BeckyHeath/MAARU/images/papers/maaru-paper.png

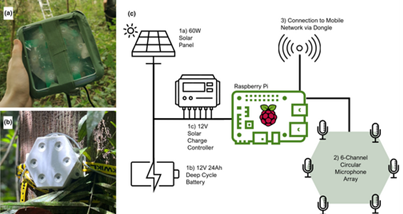
images/papers/maaru-paper.png
