BeckyHeath/MAARU/images/scc-to-step-down.jpeg

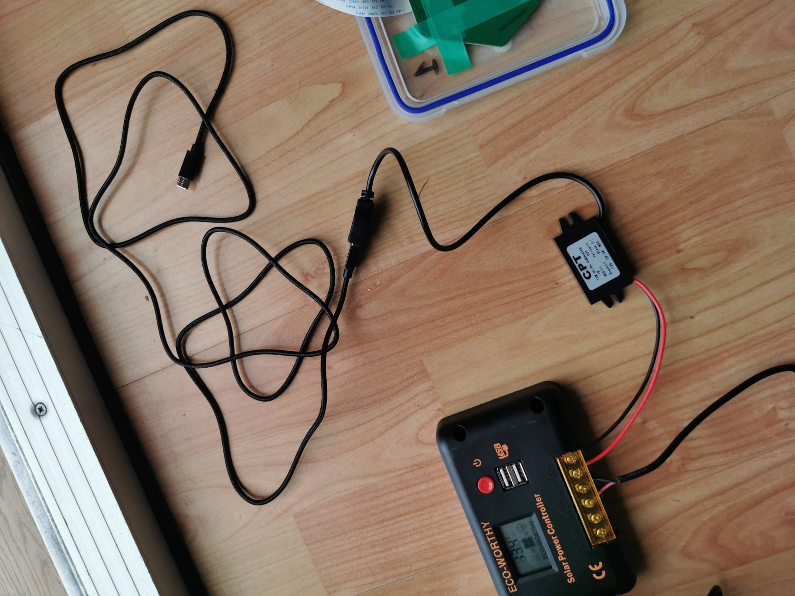
images/scc-to-step-down.jpeg
