BeckyHeath/MAARU/README.md

# MAARU Website

The codebase for the website explaining the theory and install steps for MAARU (Multichannel Acoustic Autonomous Recoring Unit)
