BeckyHeath/MAARU/images/3D-wp-shrink.png

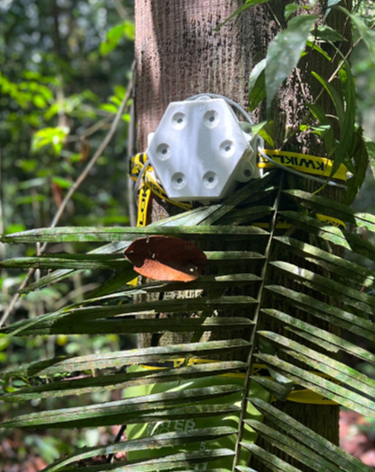
images/3D-wp-shrink.png
