BeckyHeath/MAARU/images/3Dp-wp.jpeg

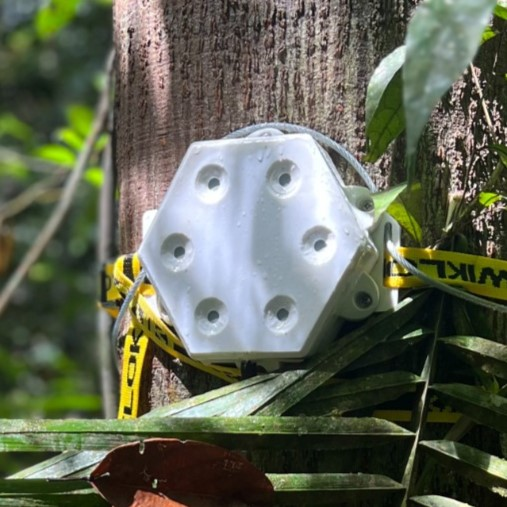
images/3Dp-wp.jpeg
