BeckyHeath/MAARU/images/all-connected.jpeg

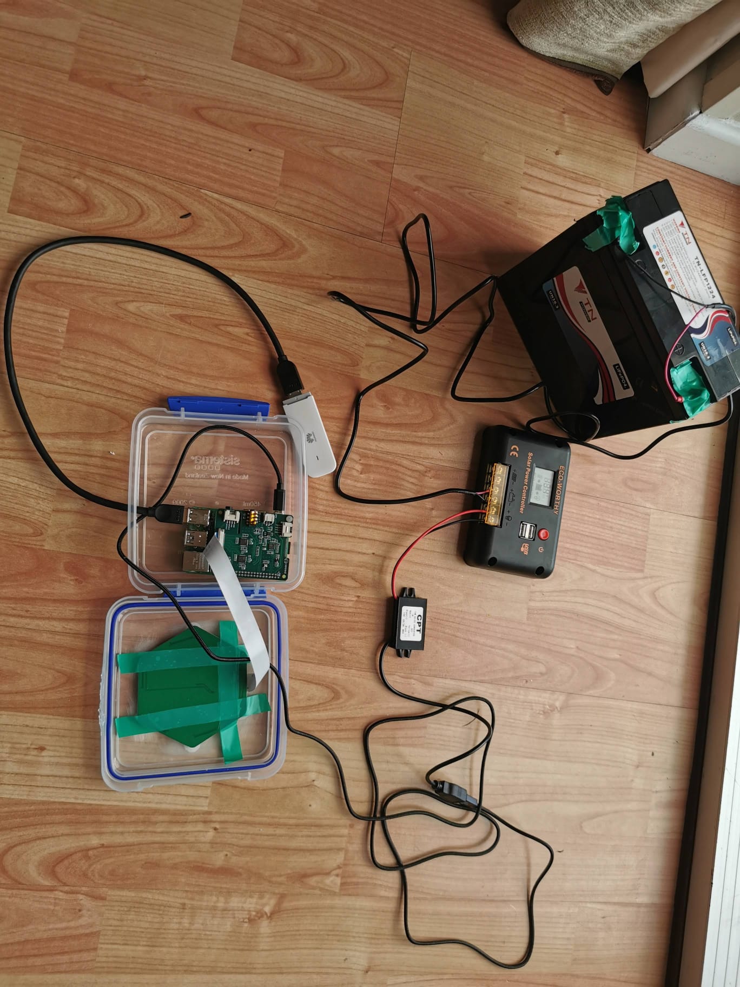
images/all-connected.jpeg
