BeckyHeath/MAARU/images/attach-dongle.jpeg

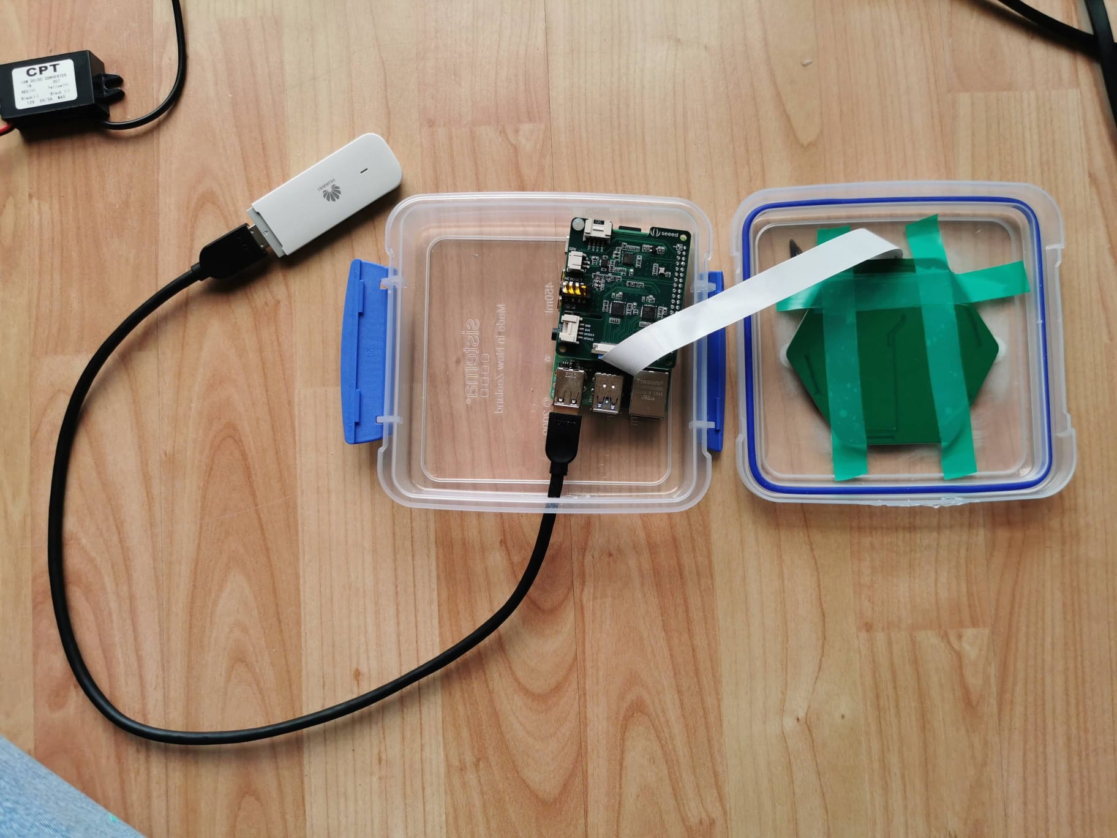
images/attach-dongle.jpeg
