BeckyHeath/MAARU/images/battery-scc.png

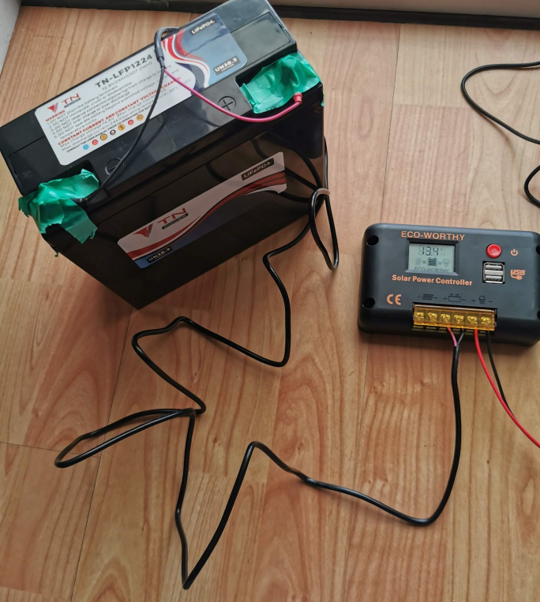
images/battery-scc.png
