BeckyHeath/MAARU/images/battery-to-scc.jpeg

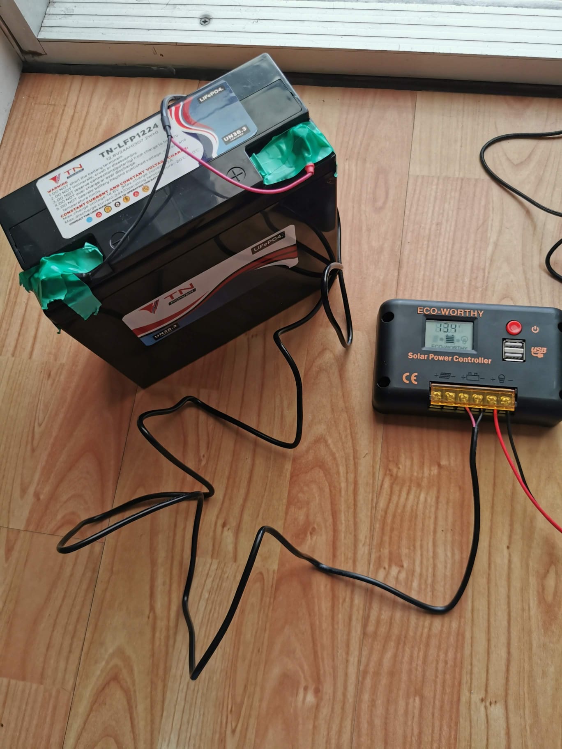
images/battery-to-scc.jpeg
