BeckyHeath/MAARU/images/bird.png

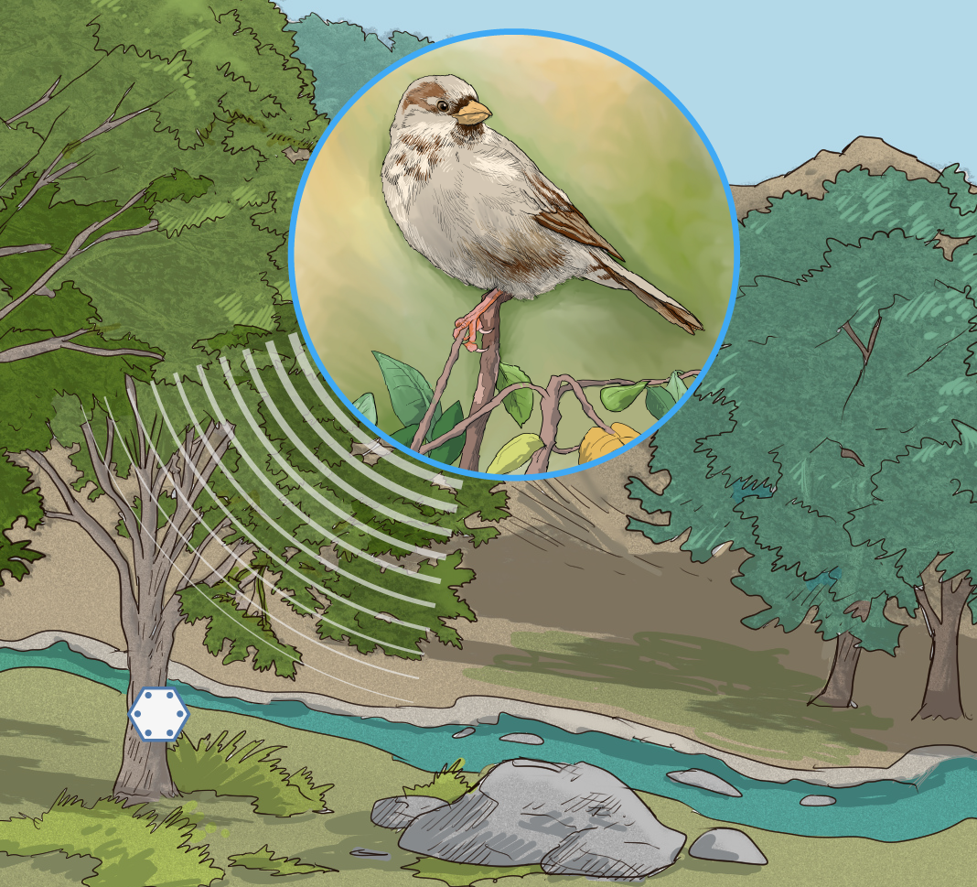
images/bird.png
