BeckyHeath/MAARU/images/diy-wp-square.png

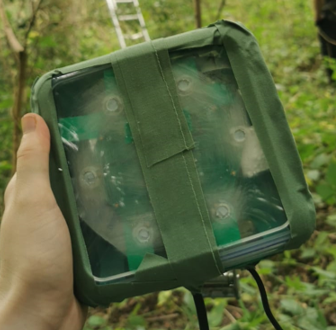
images/diy-wp-square.png
