BeckyHeath/MAARU/images/DIY-wp.jpg

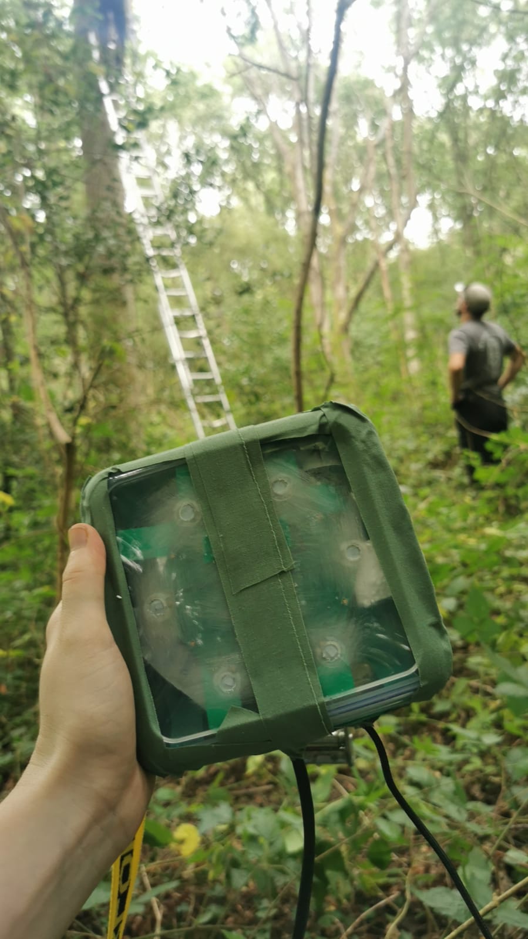
images/DIY-wp.jpg
