BeckyHeath/MAARU/images/GraphicalAbstract-Blurred.jpg

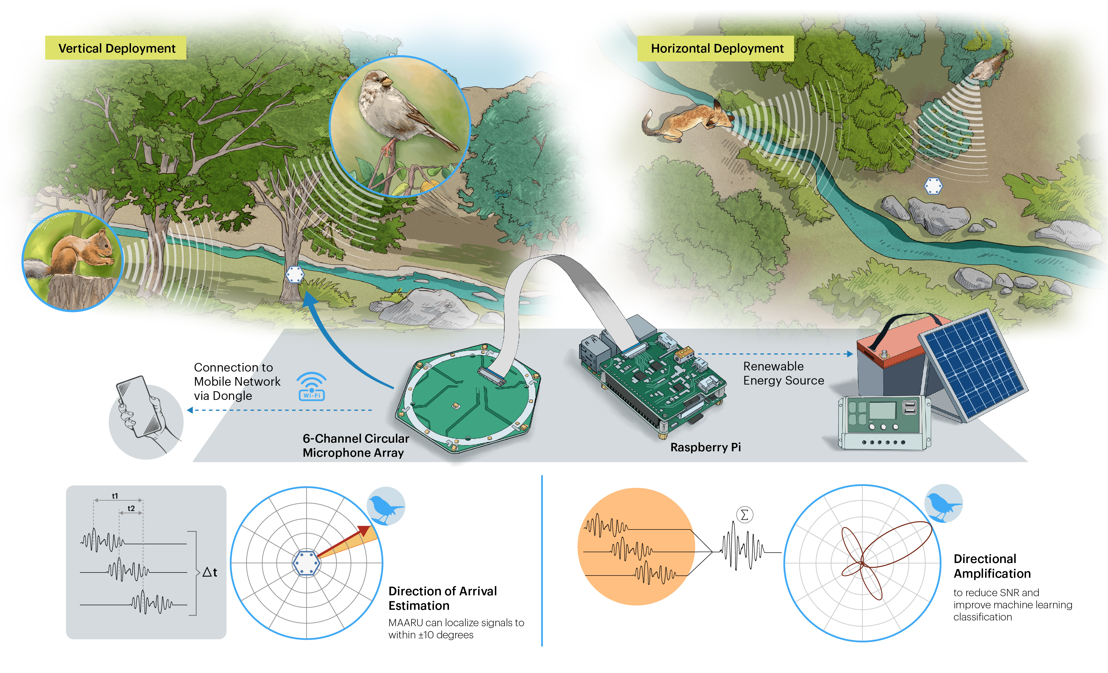
images/GraphicalAbstract-Blurred.jpg
