BeckyHeath/MAARU/images/horizontal-borderless.png

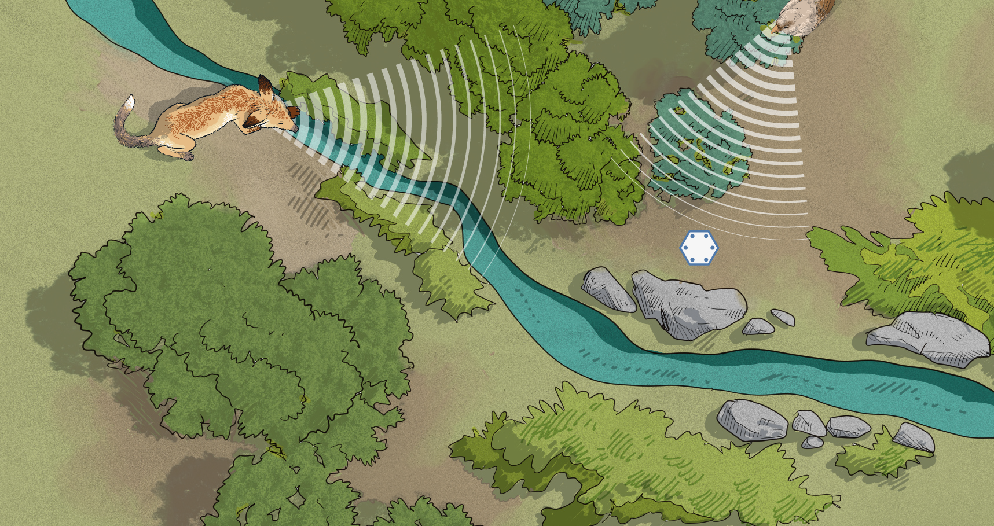
images/horizontal-borderless.png
