BeckyHeath/MAARU/images/horizontal.png

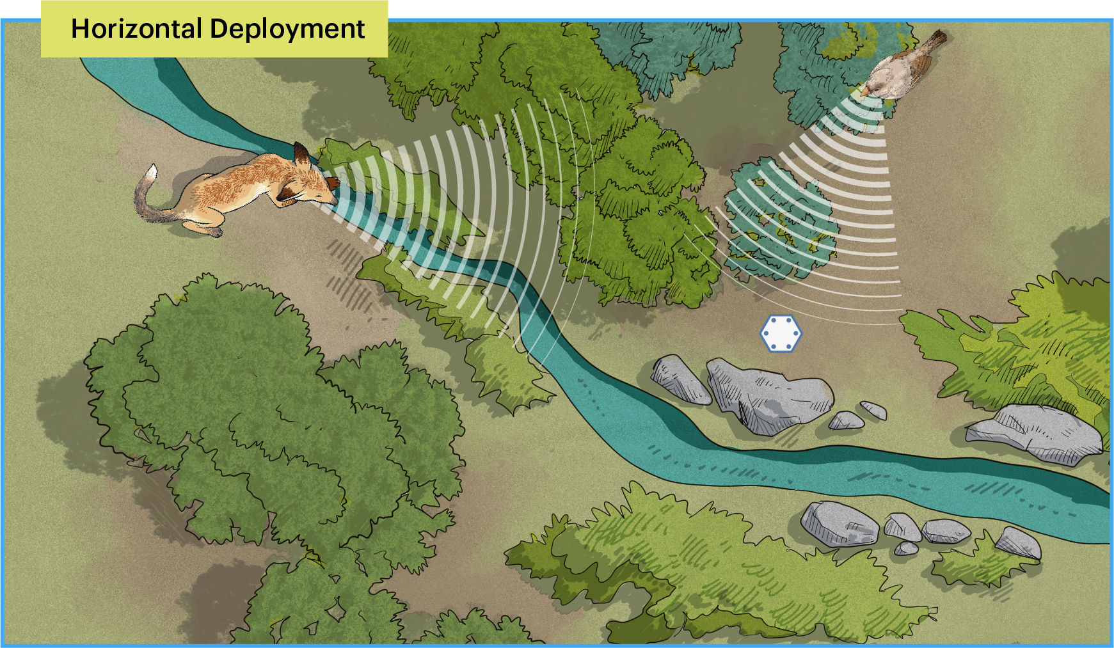
images/horizontal.png
