BeckyHeath/MAARU/images/KCC.png

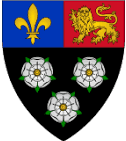
images/KCC.png
