BeckyHeath/MAARU/images/MAARU_Schematic.png

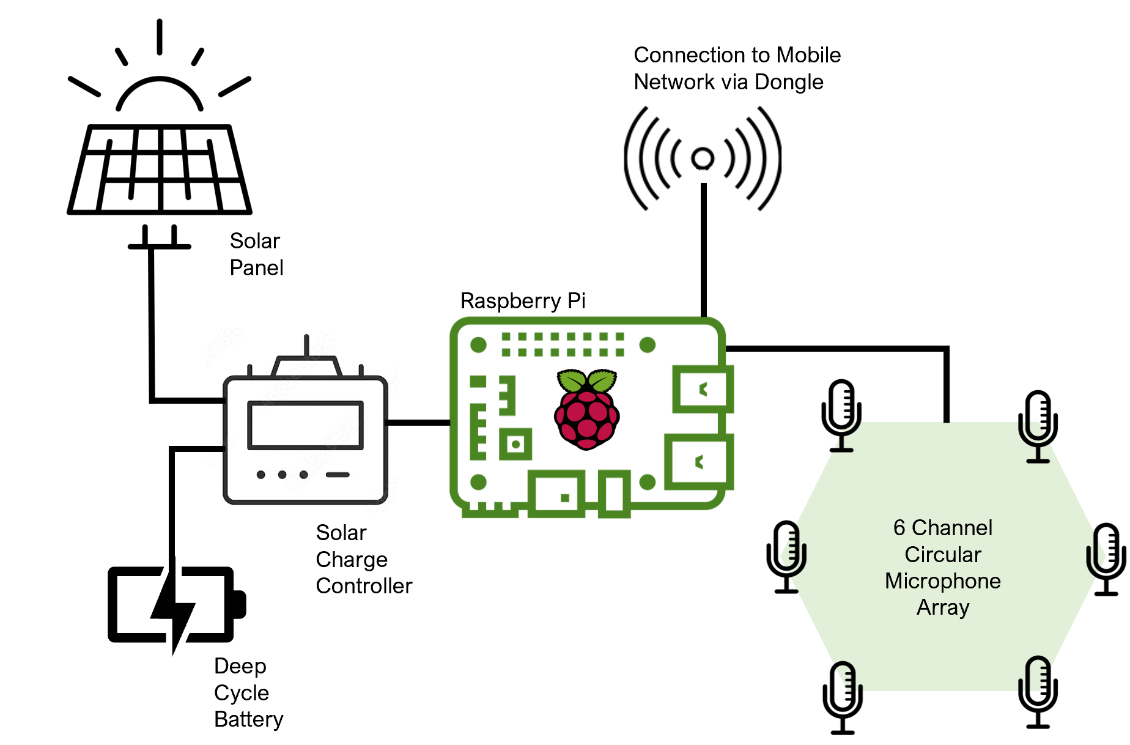
images/MAARU_Schematic.png
