BeckyHeath/MAARU/images/papers/recording-nature.png

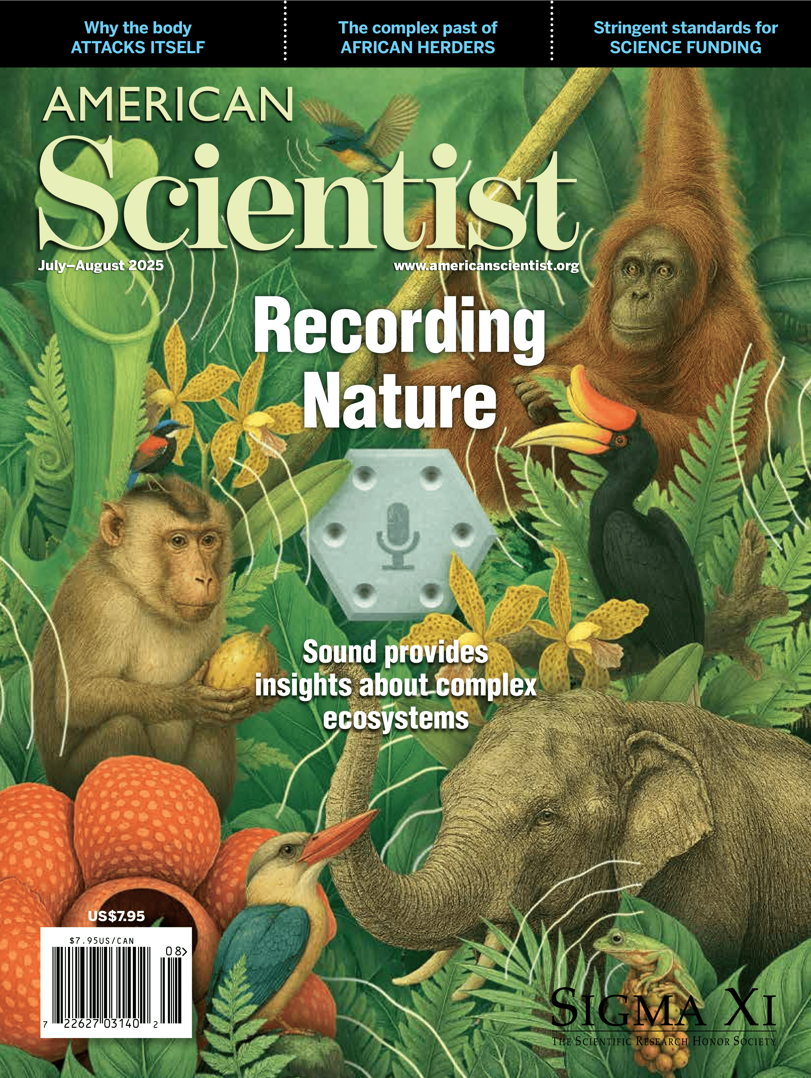
images/papers/recording-nature.png
