BeckyHeath/MAARU/images/papers/vse-paper.jpg

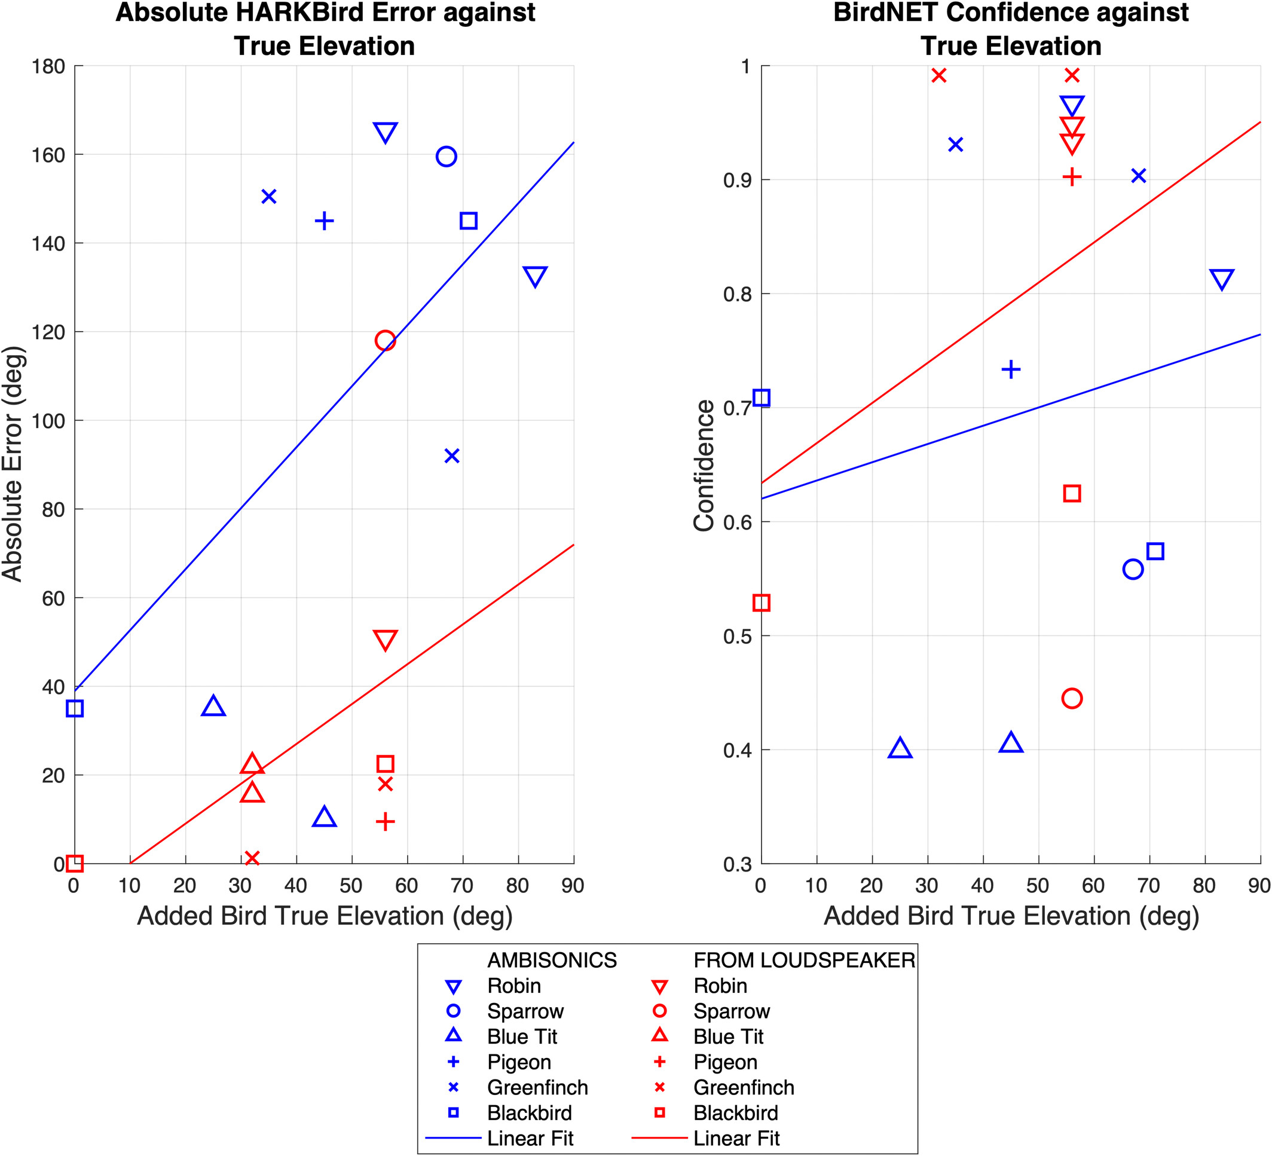
images/papers/vse-paper.jpg
