BeckyHeath/MAARU/images/people/BH.jpg

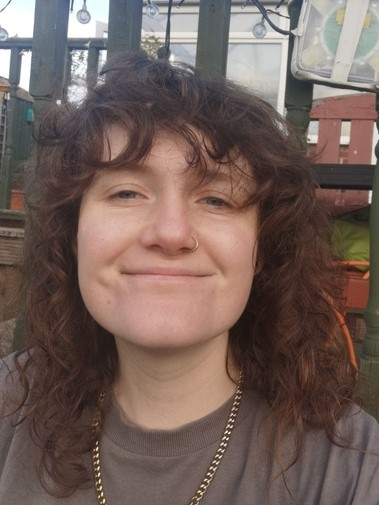
images/people/BH.jpg
