BeckyHeath/MAARU/images/people/JS.jpg

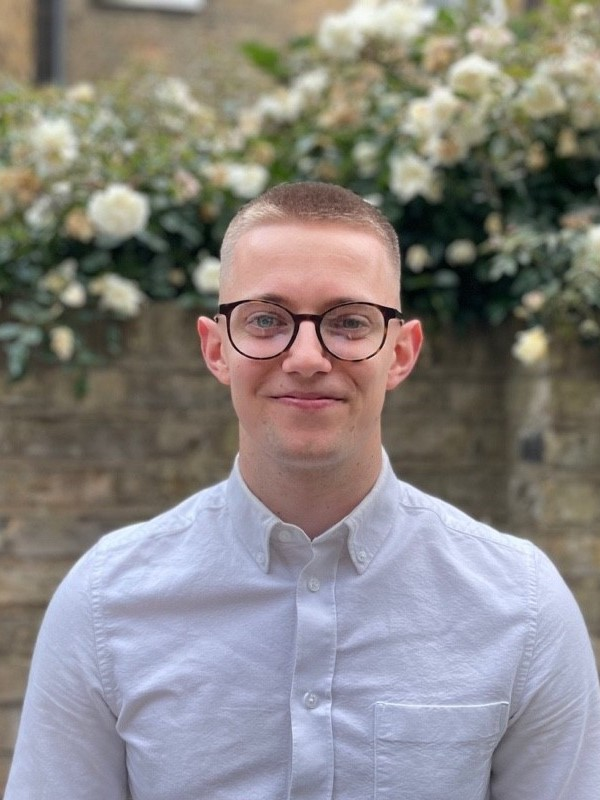
images/people/JS.jpg
