BeckyHeath/MAARU/images/people/LP.jpg

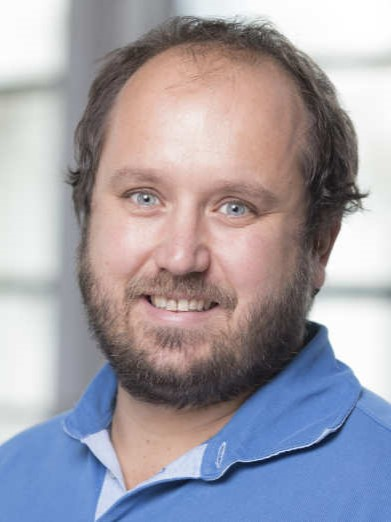
images/people/LP.jpg
