BeckyHeath/MAARU/images/people/NLP.jpg

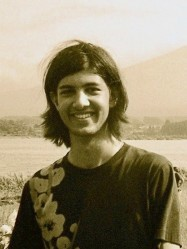
images/people/NLP.jpg
