BeckyHeath/MAARU/images/people/RE.jpg

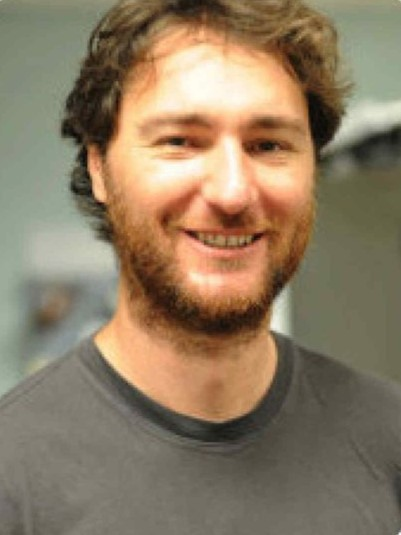
images/people/RE.jpg
