BeckyHeath/MAARU/images/people/RM.png

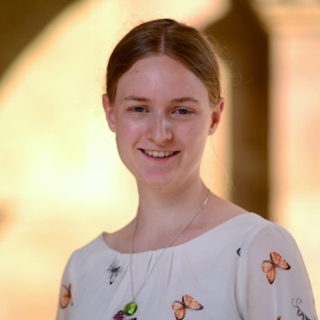
images/people/RM.png
