BeckyHeath/MAARU/images/people/RS.png

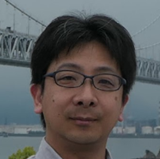
images/people/RS.png
