BeckyHeath/MAARU/images/people/SS.jpg

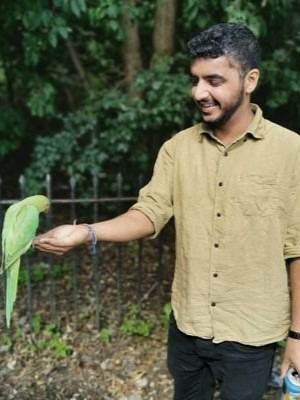
images/people/SS.jpg
