BeckyHeath/MAARU/images/phone.png

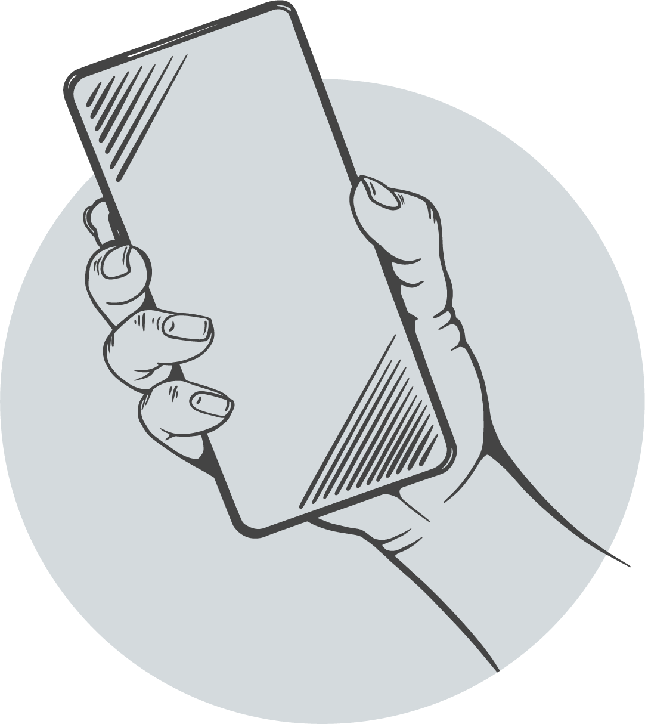
images/phone.png
