BeckyHeath/MAARU/images/powering.png

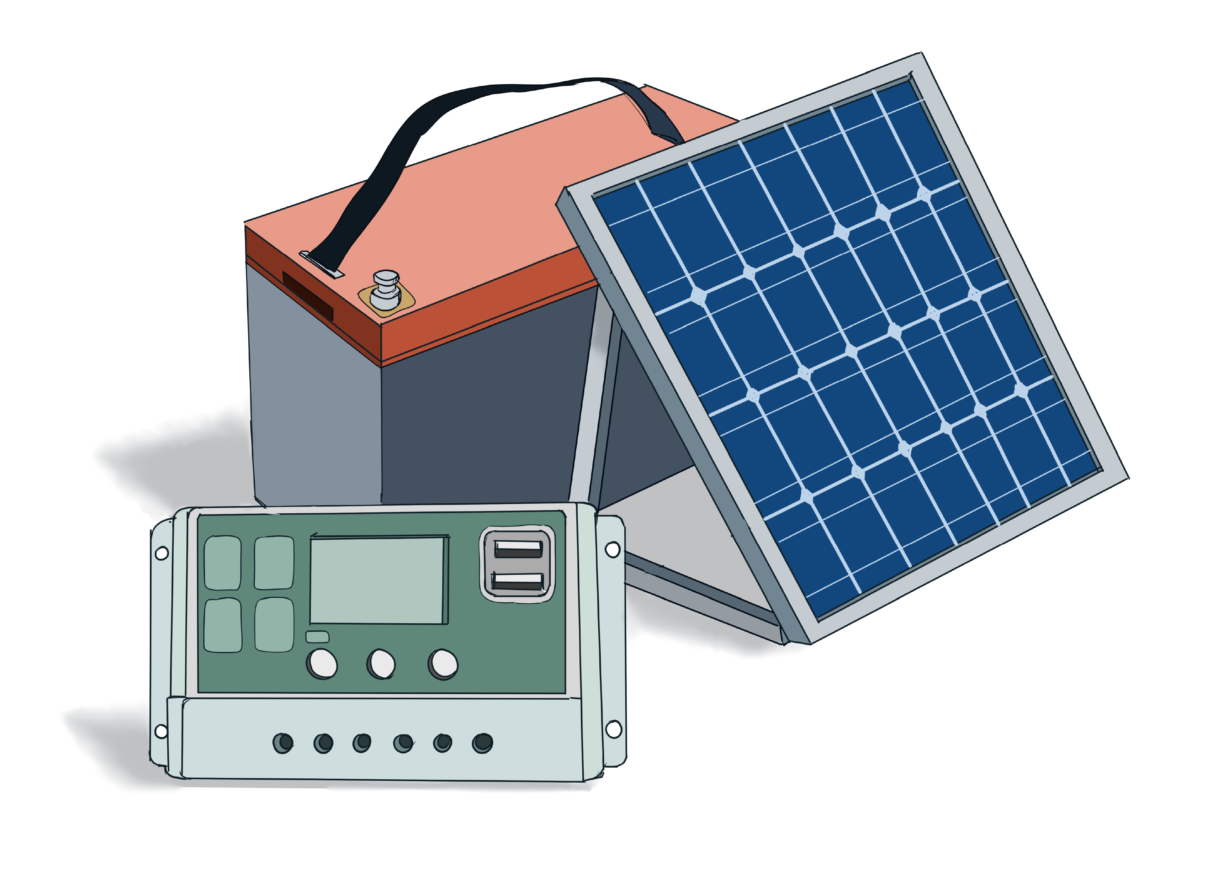
images/powering.png
