BeckyHeath/MAARU/images/Rpi-Array.png

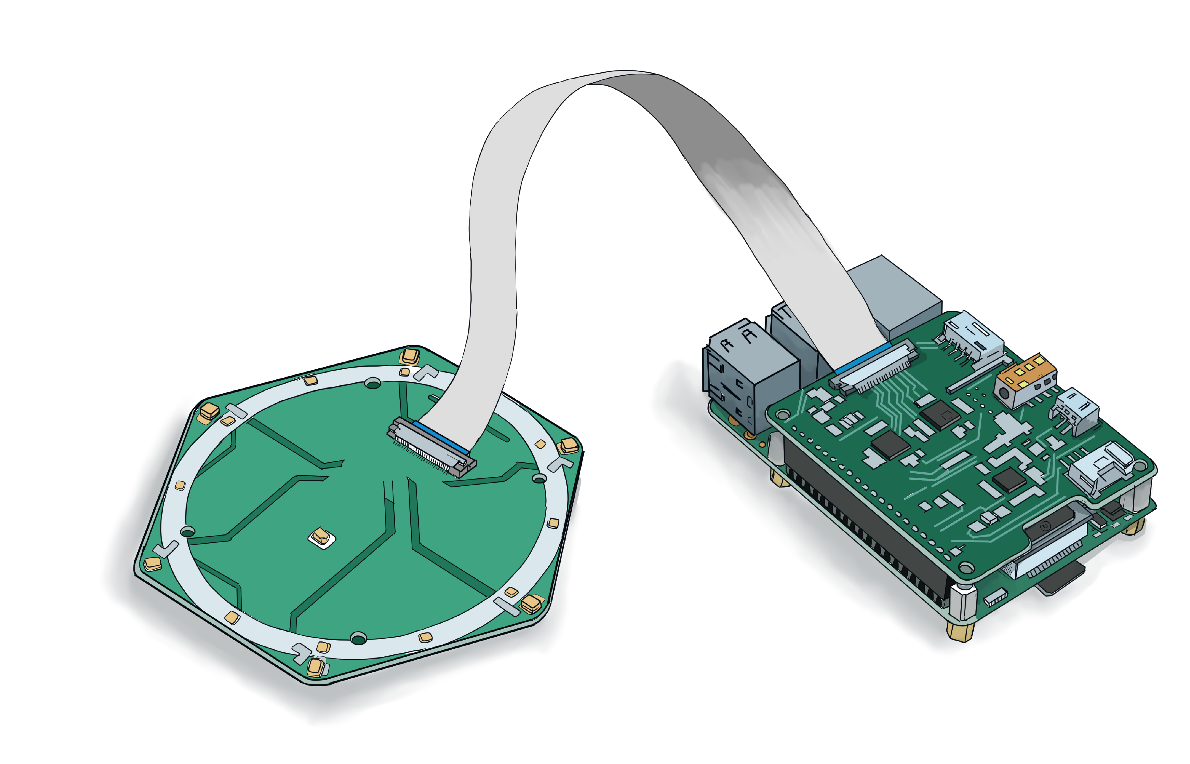
images/Rpi-Array.png
