BeckyHeath/MAARU/images/scc-stepdown.png

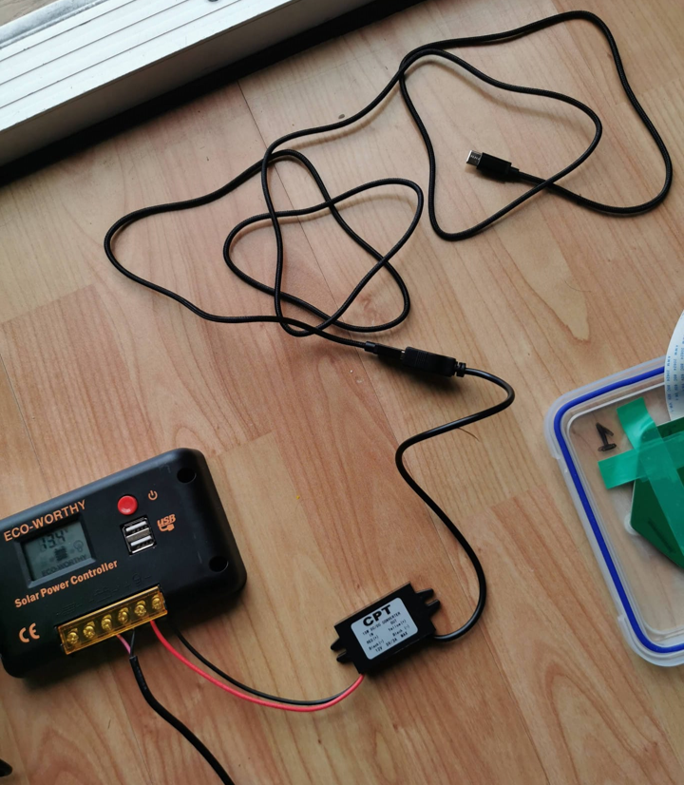
images/scc-stepdown.png
