BeckyHeath/MAARU/images/sealedTuppholes.png

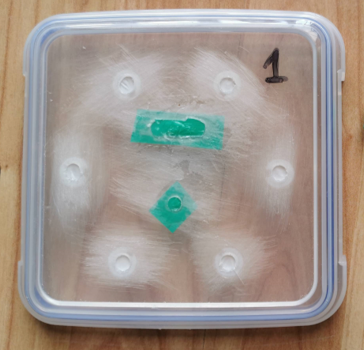
images/sealedTuppholes.png
