BeckyHeath/MAARU/images/solar-charge-controller.jpeg

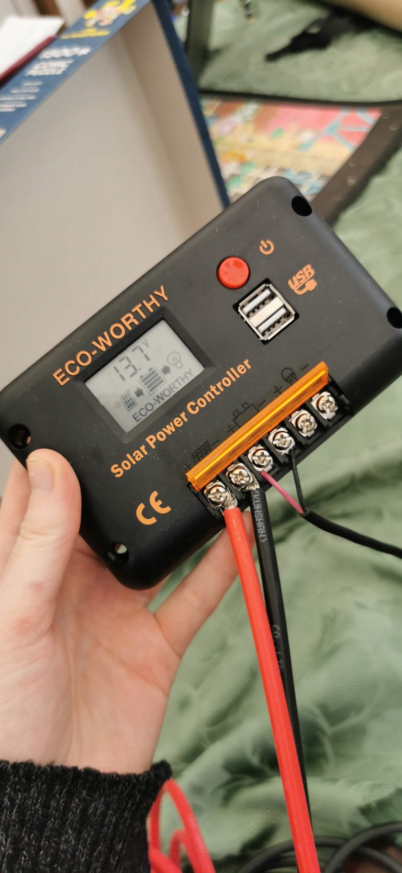
images/solar-charge-controller.jpeg
