BeckyHeath/MAARU/images/solar-panel.jpeg

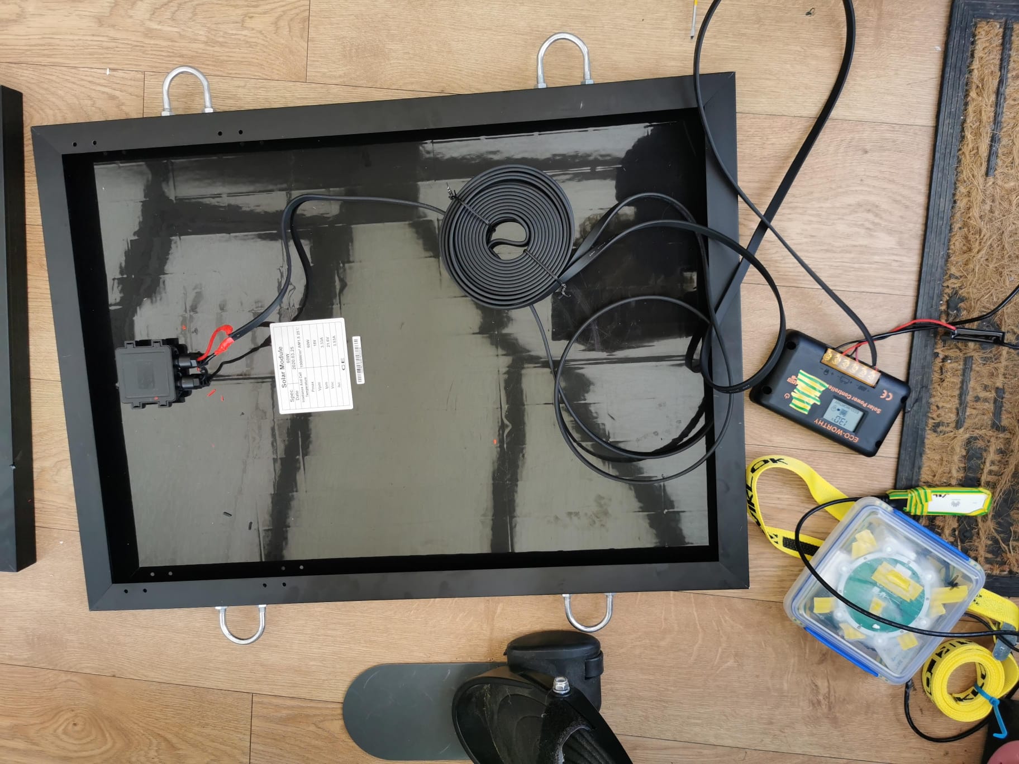
images/solar-panel.jpeg
