BeckyHeath/MAARU/images/solar-scc.png

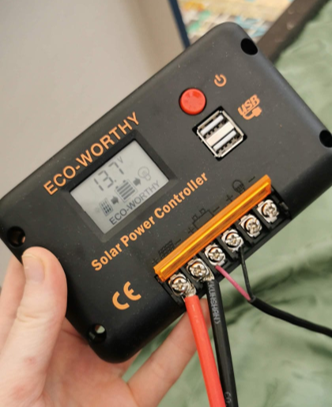
images/solar-scc.png
