BeckyHeath/MAARU/images/Spatial-Acoustics-Diagrams.png

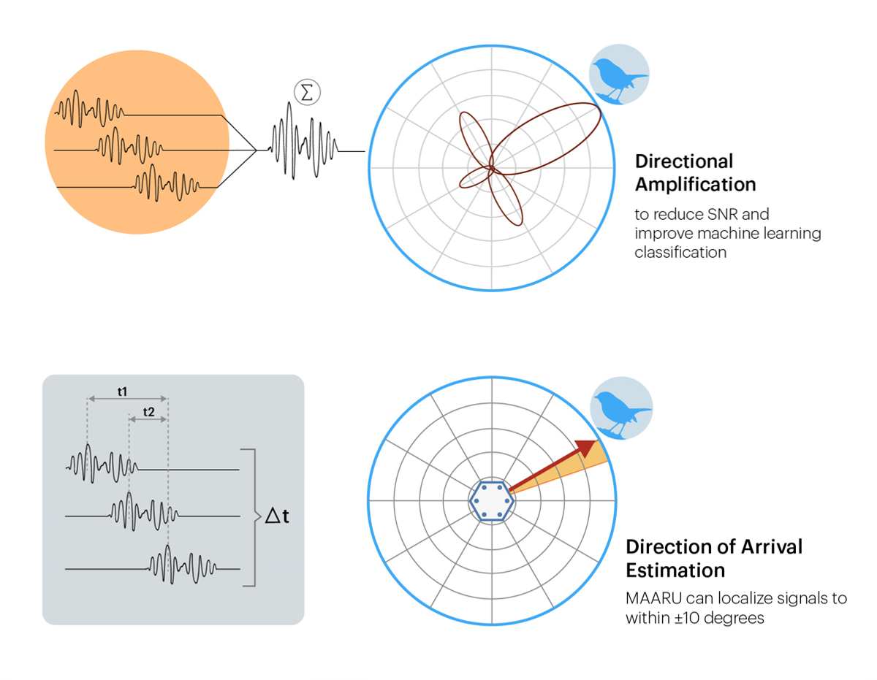
images/Spatial-Acoustics-Diagrams.png
