BeckyHeath/MAARU/images/tuppaware-holes.jpeg

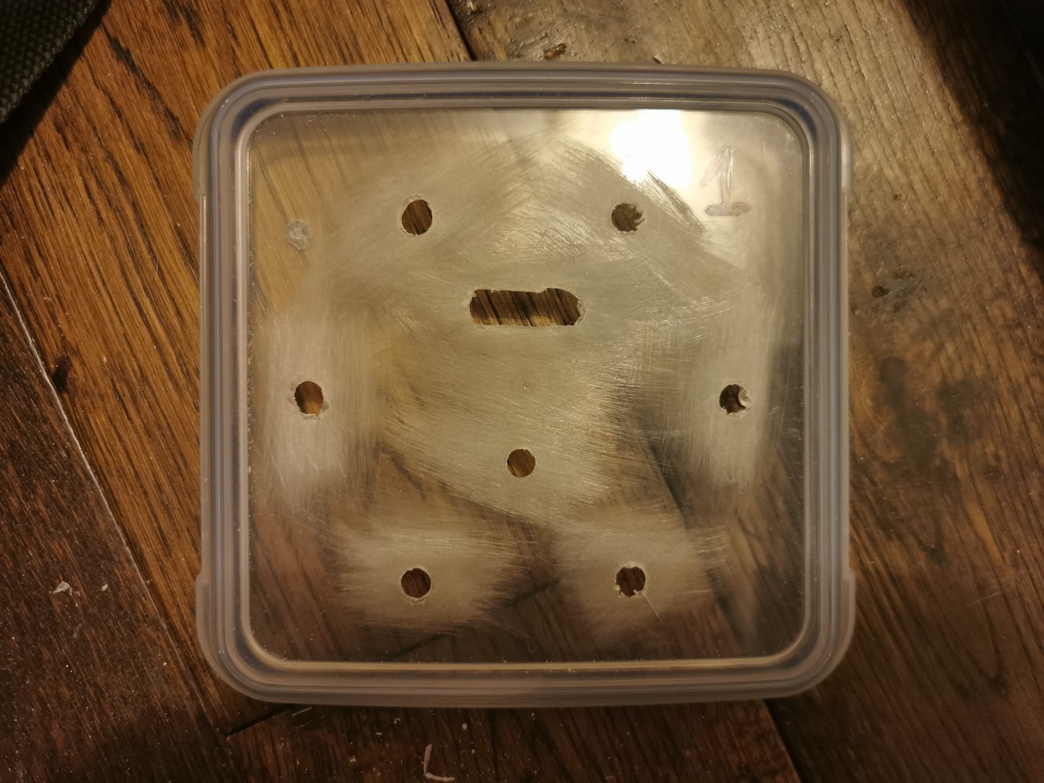
images/tuppaware-holes.jpeg
