BeckyHeath/MAARU/images/tupperware-holes.jpg

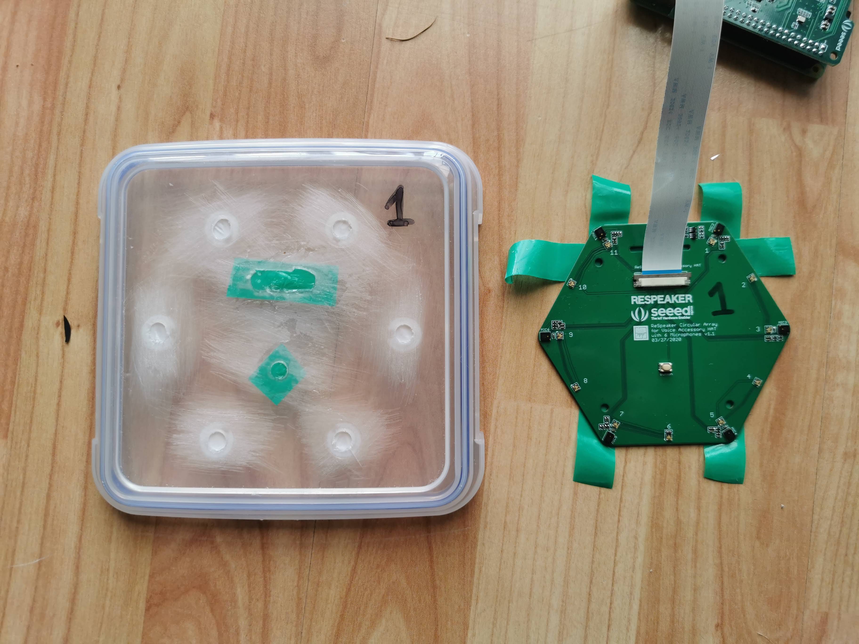
images/tupperware-holes.jpg
