BeckyHeath/MAARU/images/tuppholes.png

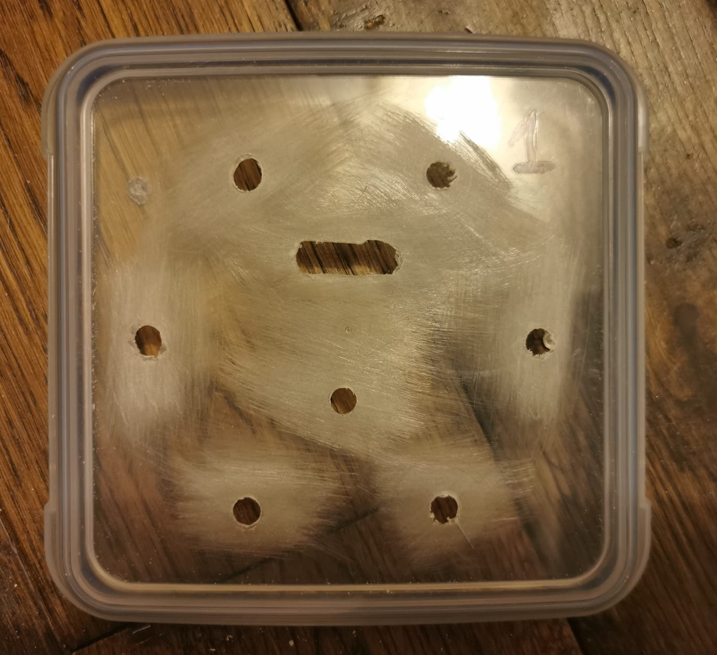
images/tuppholes.png
