BeckyHeath/MAARU/images/vertical.png

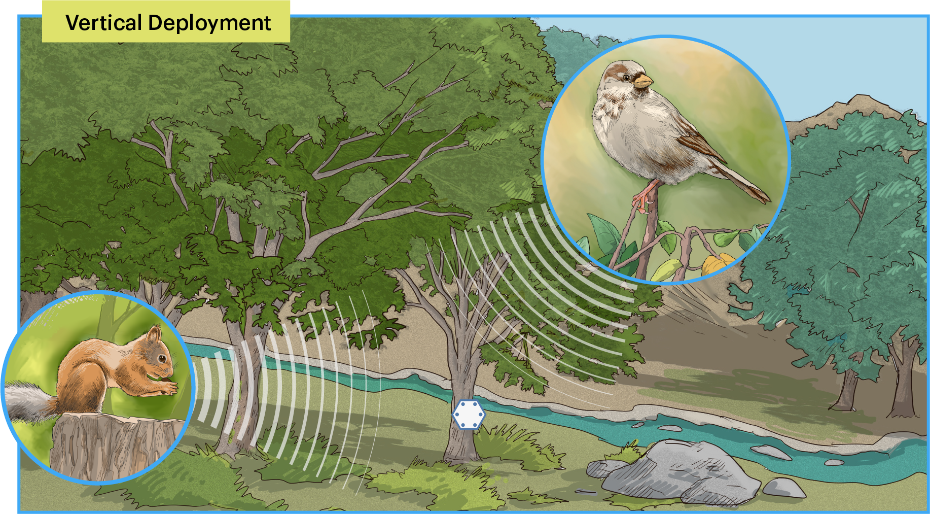
images/vertical.png
