BeckyHeath/MAARU/images/WhatsApp Image 2023-10-13 at 04.29.46.jpeg

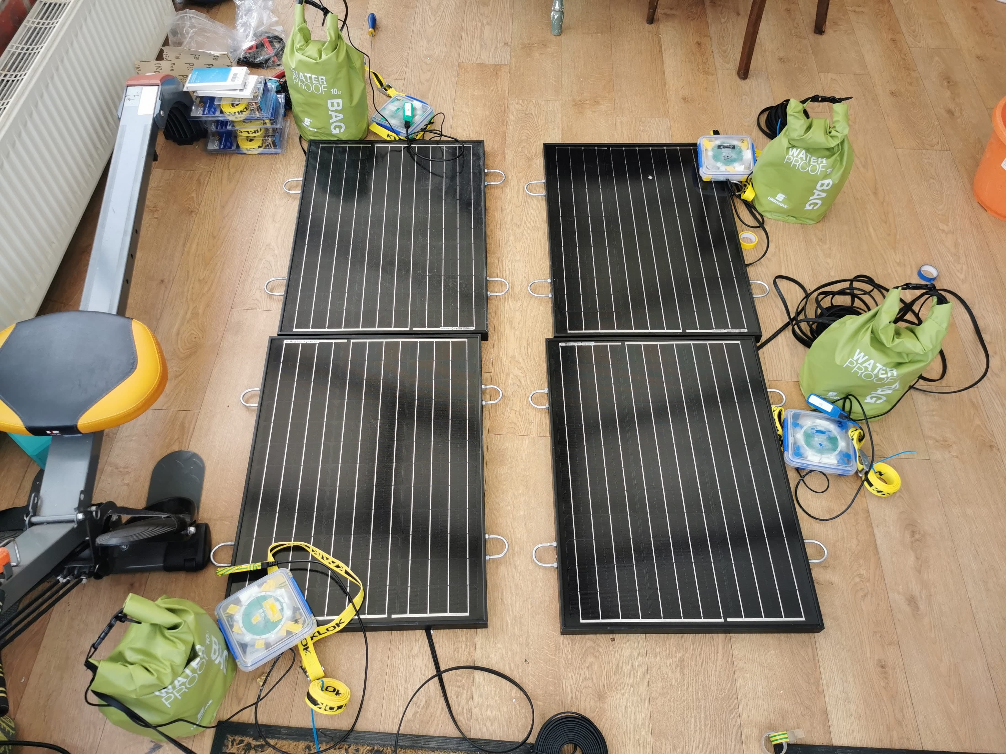
images/WhatsApp Image 2023-10-13 at 04.29.46.jpeg
