BeckyHeath/MAARU/images/whole-device.png

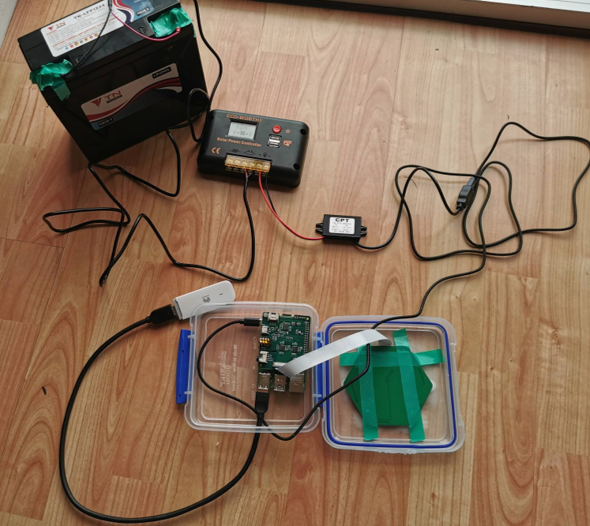
images/whole-device.png
