BeckyHeath/MAARU/images/zoom.jpg

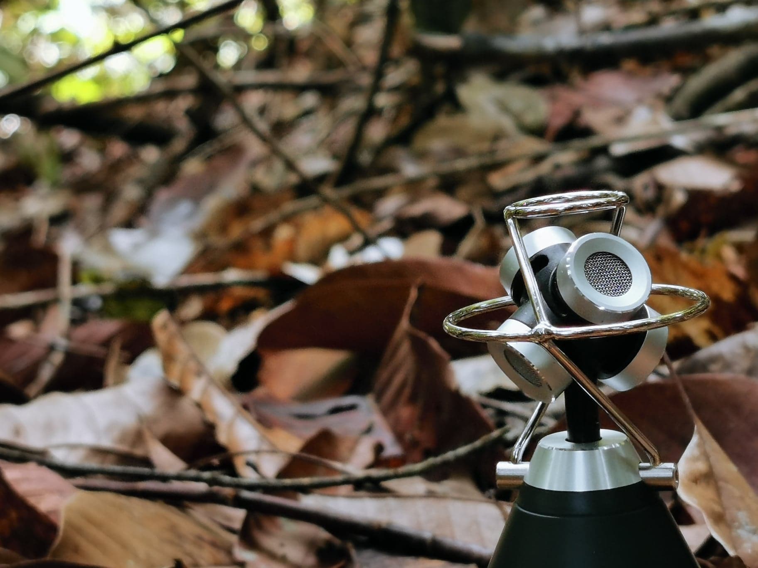
images/zoom.jpg
