BeckyHeath/MAARU/documents/3D-case/CAD Files/AMARU_TopCase.STL

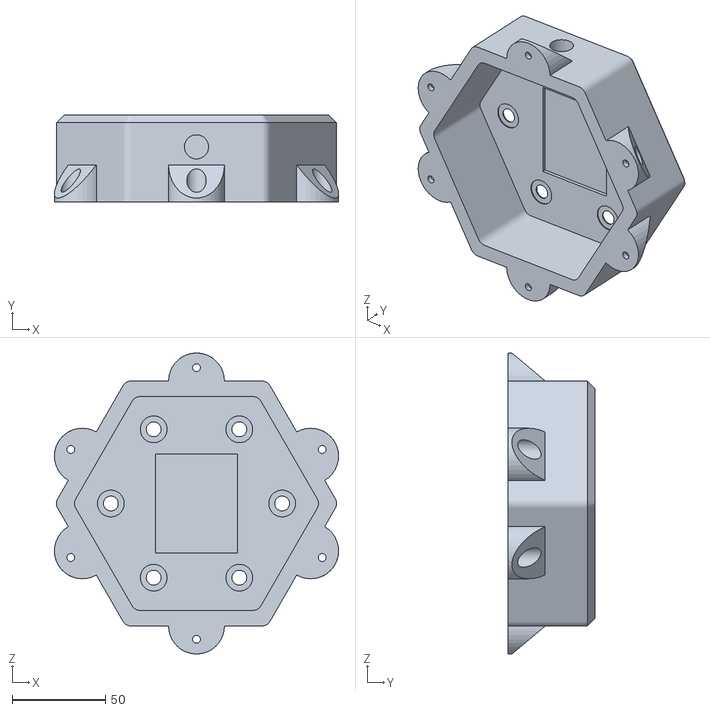
[picture p58: CAD file, 2023-10-15]
documents/3D-case/CAD Files/AMARU_TopCase.STL
152.6 x 46.5 x 161.6
