BeckyHeath/MAARU/documents/3D-case/CAD Files/AMARU_BasePlate.STL

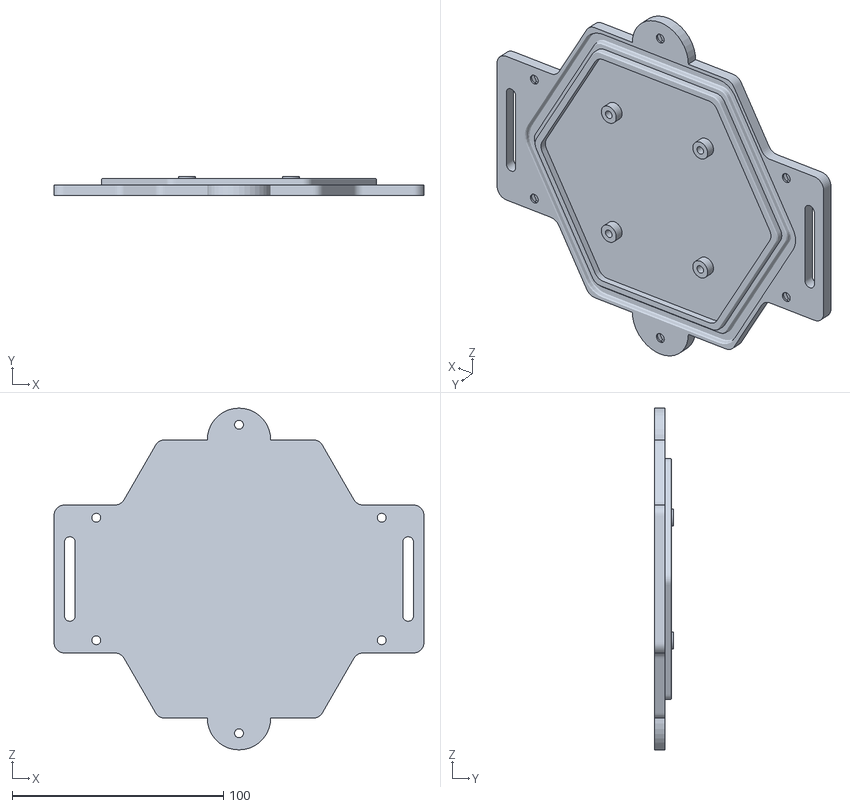
[picture p59: CAD file, 2023-10-15]
documents/3D-case/CAD Files/AMARU_BasePlate.STL
175.0 x 9.00 x 161.6
