BeckyHeath/MAARU/documents/3D-case/Assembly_Instructions.pdf

James Skinner, June 2023
AMARU - Step-by-step Assembly Instructions

Overview

This documentation refers to assembly of the Amazon Multichannel Autonomous Recording Unit (AMARU): developed for James Skinner’s master’s project.

For a list of required components and links to purchase them, refer to this spreadsheet. (https://docs.google.com/spreadsheets/d/1wotfAZApMUj4tcFPdh2UBsMQqyj9QS6KycnfAqtqY8s/edit?usp=sharing)

Tools required to perform this assembly:

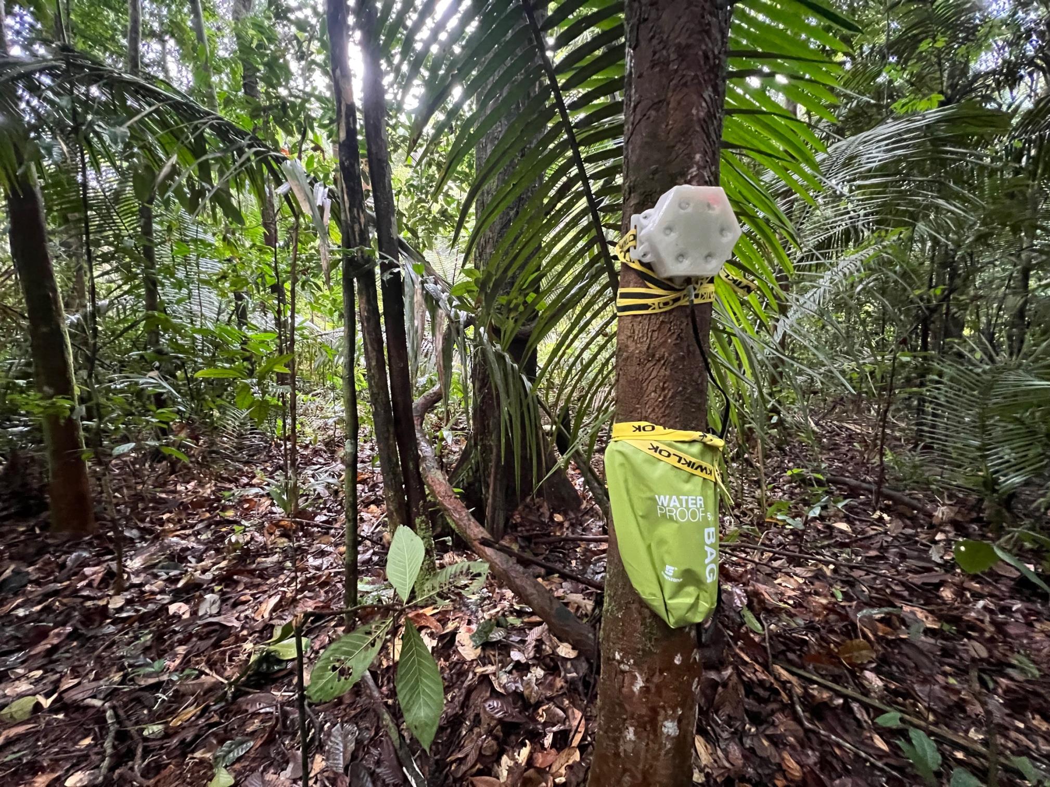
[picture p63: figure]

- 3D Printer (I used a Prusa MK3S)
- Pliers
- Deburring Tool
- Paintbrush
- Gloves
- Plastic Cups
- Mixing Sticks
- Cutting Mat
- Stanley Knife
- Soldering Iron
- Small Screwdriver
- Tweezers
- Duct Tape

Assembly

1 | 2 | 3 | 4

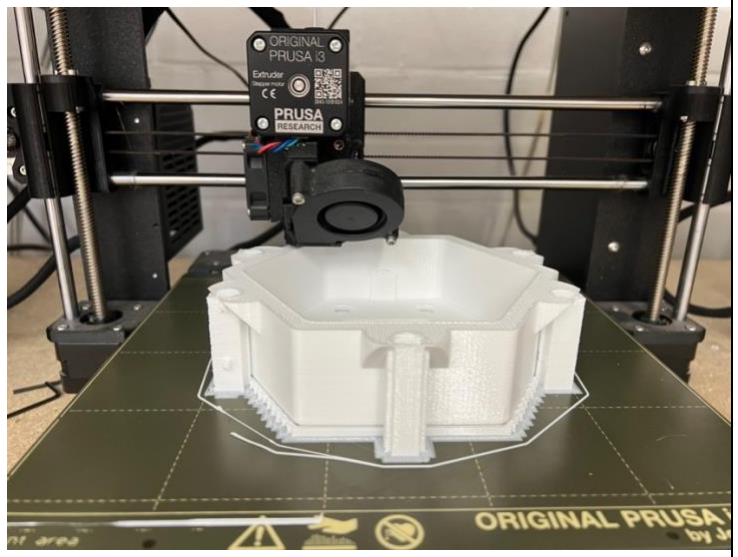
[picture p64: figure]
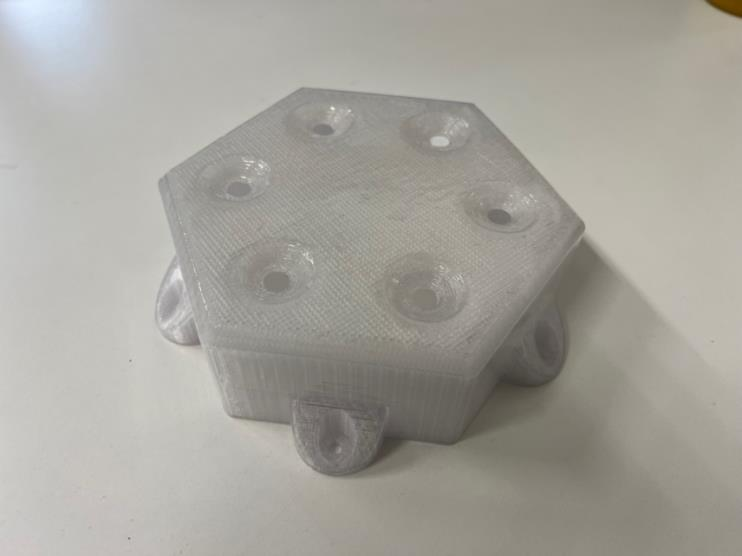
[picture p65: figure]
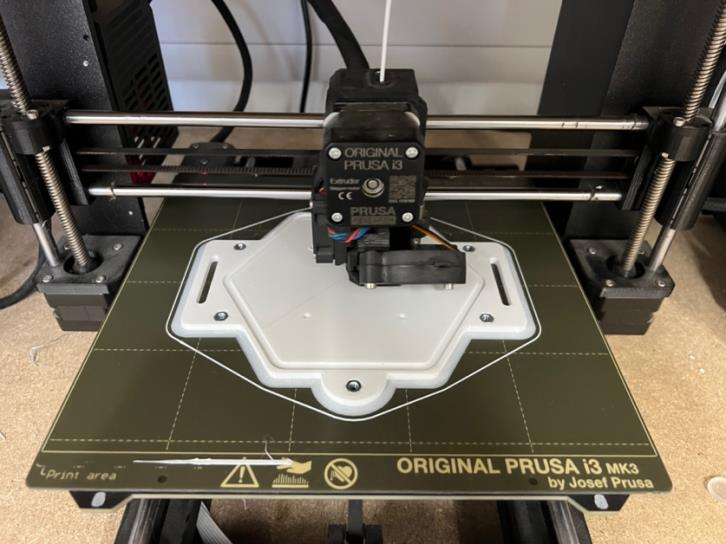
[picture p66: figure]
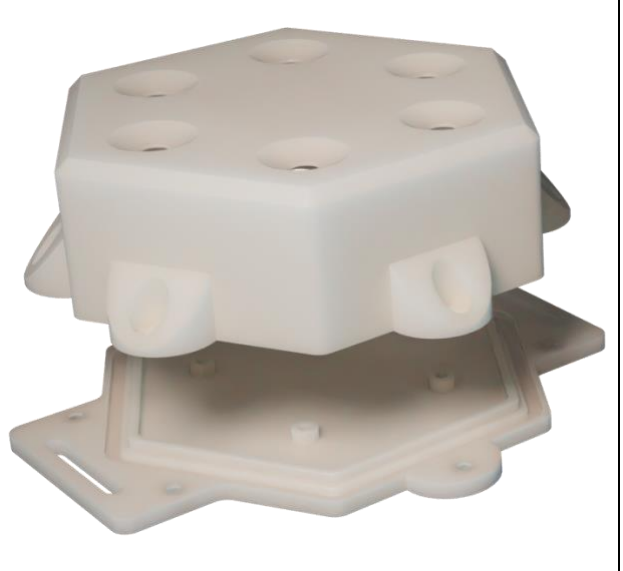
[picture p67: figure]

Download the AMARU casing STL files from the following link: STL Files (https://drive.google.com/drive/folders/1b9wD-DWbqm3pzwqg_jkfNGsdnzan1Paq?usp=share_link) | Use a 3D printer to print the casing, using PETG. The following settings should be used: 3-layer wall thickness, 0.2 mm layer height, 40% infill density. | Add a print pause before printing the base plate, at the layer before hex-nut holes are covered. Once paused, insert the 6 hexnuts into their respective positions. | Once the parts are printed, remove any support material. A small pair of pliers and a deburring tool are useful, here.
5 | 6 | 7 | 8

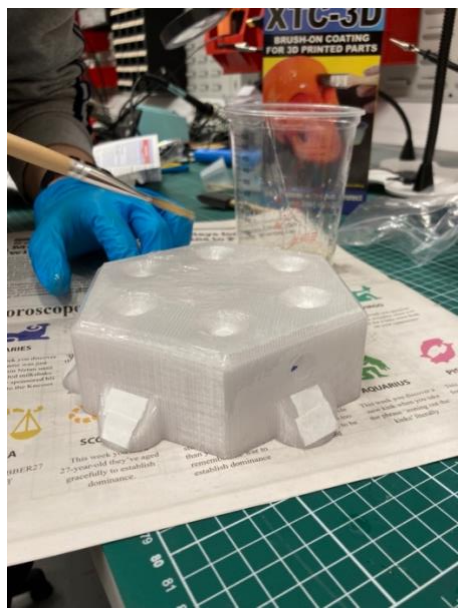
[picture p68: figure]

Apply two coats of XTC-3D epoxy resin to both parts of the casing. Make sure to wear gloves and a ventilation mask. Allow to dry between coats for at least 24 hours.

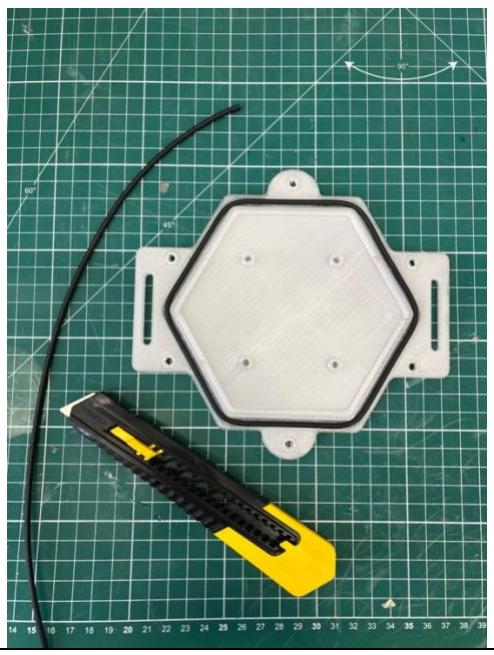
[picture p69: figure]

Measure out an appropriate length of O-ring tubing. This should fit within the gland: slightly loose. Cut to the correct length. Then, use a small amount of super glue to attach the ends together. Place the O-ring within the gland.

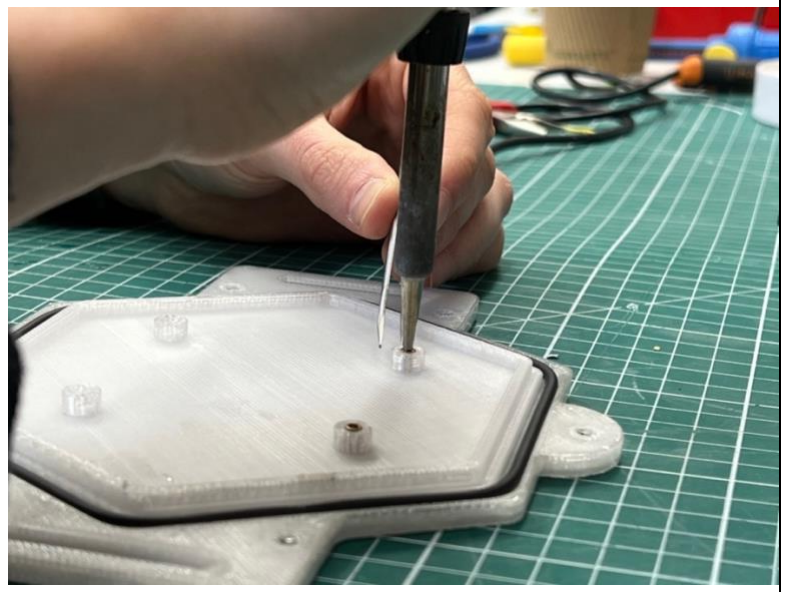
[picture p70: figure]

Use tweezers and a soldering iron to carefully melt the threaded inserts into place. The inserts heat up very quickly, so ensure they are properly aligned with the holes before applying the soldering iron.

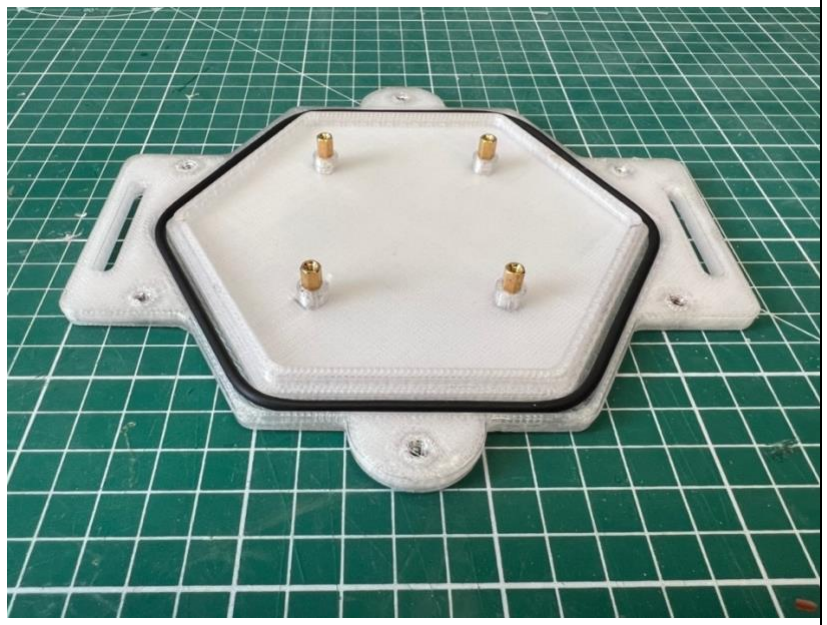
[picture p71: figure]

Screw the 4 M2.5*6+6 metal standoff screws into the threaded inserts.

9 | 10 | 11 | 12

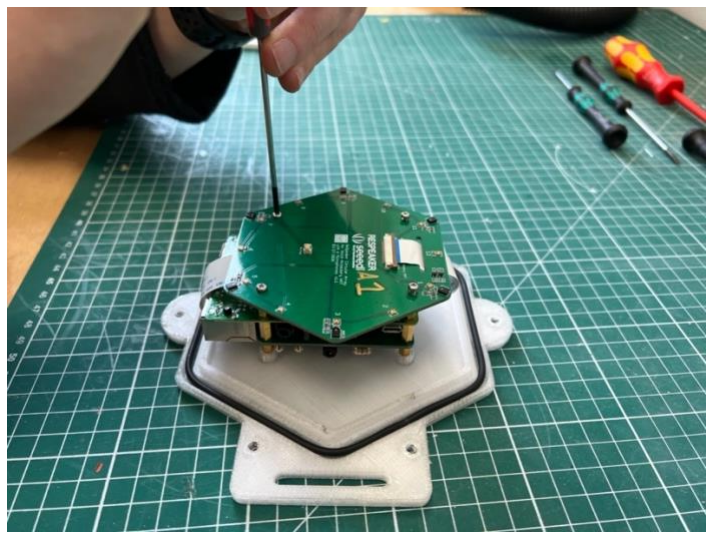
[picture p72: figure]
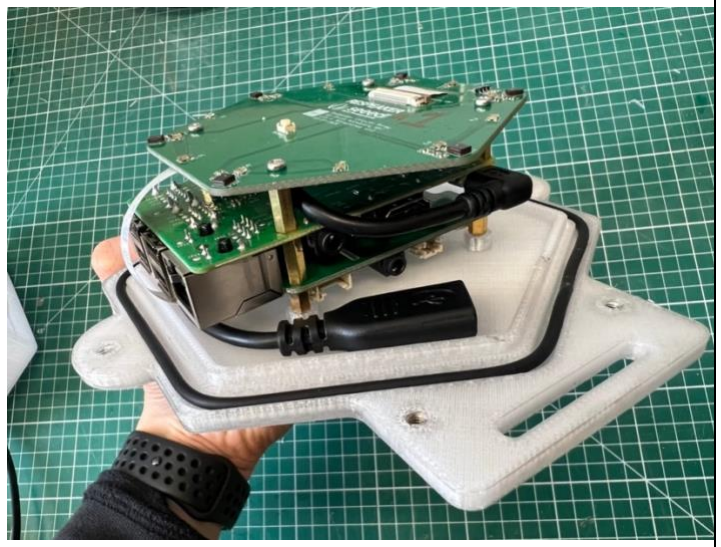
[picture p73: figure]
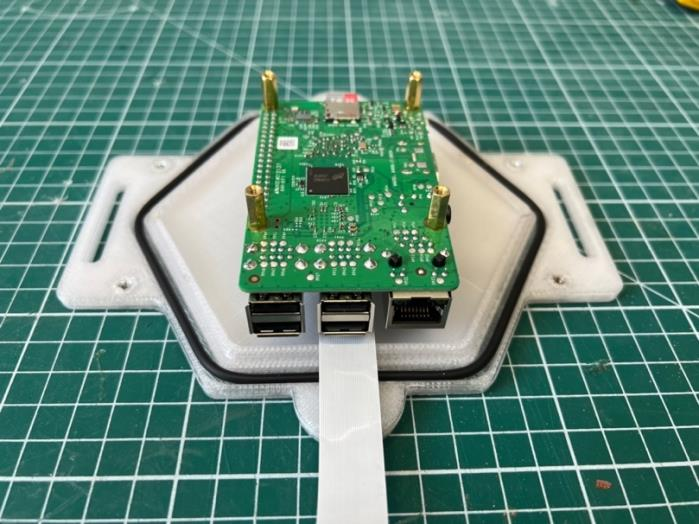
[picture p74: figure]
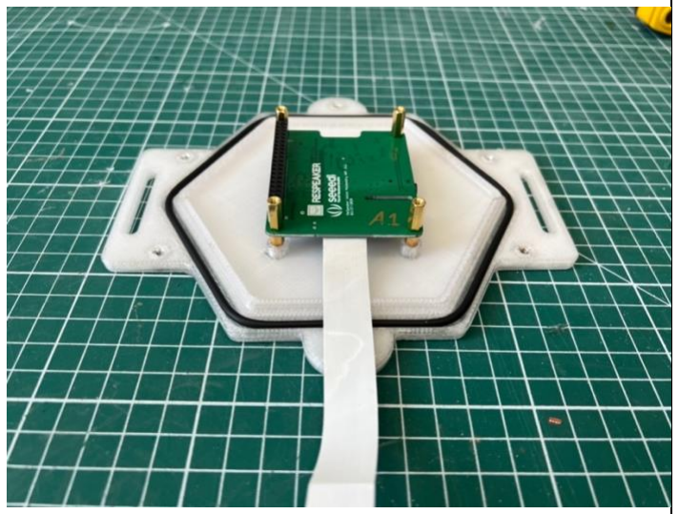
[picture p75: figure]

Place the Respeaker sound card upside down, on top of the standoff screws. Then, fix it in place by screwing in 4 M2.5*12+6 standoff screws. | Place the Raspberry Pi upside down, on top of the standoff screws and sound card. Fix it in place by screwing in another 4 M2.5*12+6 standoff screws. | Pass the ribbon cable from the sound card through the slot in the microphone array, and plug it in. Then, position the mic array on top of the standoff screws, and fix in place using the 4 M2.5*6 screws. | Plug in the micro-USB to USB-C right angled connector and pass through the device as shown.
13 | 14 | 15 | 16

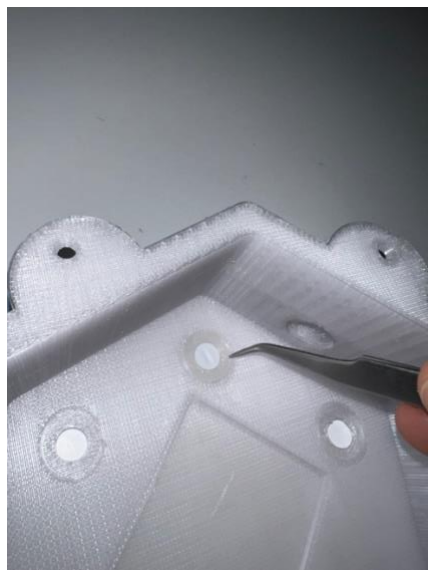
[picture p76: figure]
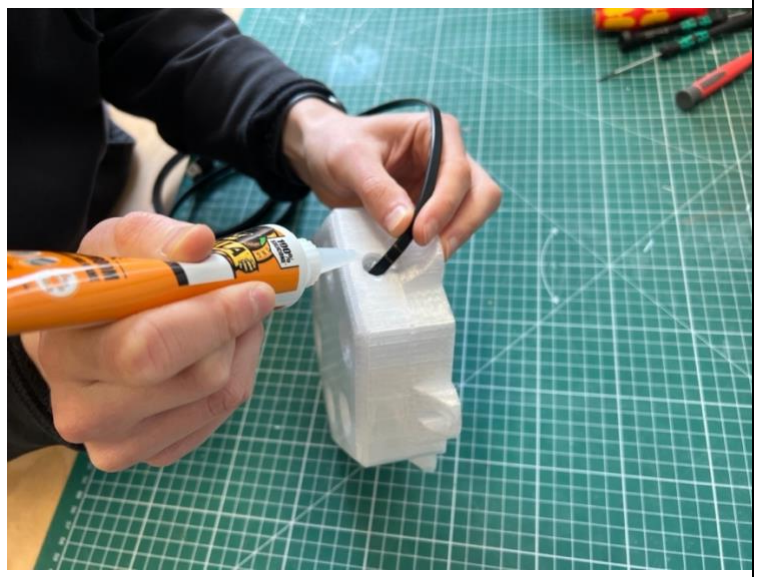
[picture p77: figure]
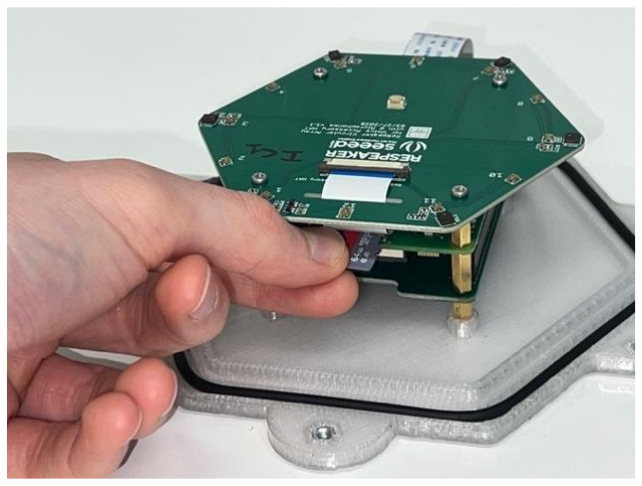
[picture p78: figure]
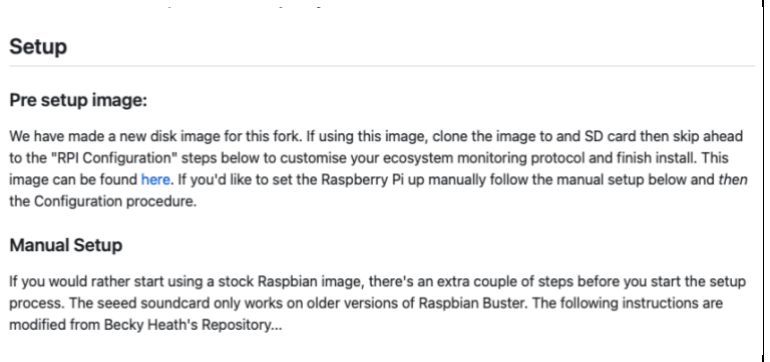
[picture p79: figure]

Use a pair of tweezers to lay the ePTFE acoustic vents into the insets of the microphone holes. | Pass the power cable through the hole in the top casing, and plug it into the USB-C adapter. Close the casing and ensure that there is sufficient cable length inside the device. Mark the position where the cable protrudes from the hole. Then, unplug the cable from the adapter, and glue it into place using Silicon Sealant. Allow to set for at least 24 hours. | Install the disk image onto an SD card by following these instructions. (https://github.com/JamesSkinna/multi-channel-rpi-eco-monitoring) This SD card should be at least 64 GB, with a minimum of 150 MB/s write speeds. | Plug the SD card into the Raspberry Pi.

17 | 18 | 19 | 20

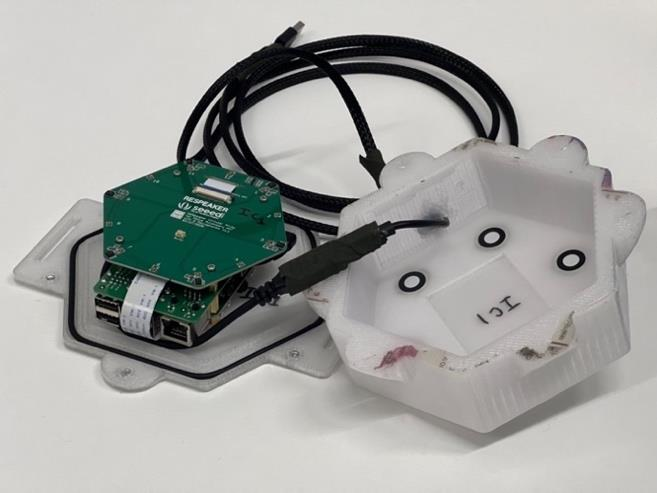
[picture p80: figure]
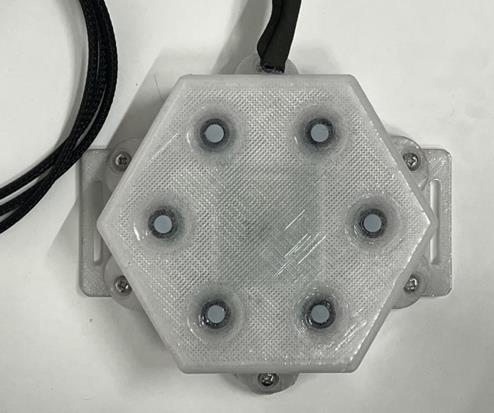
[picture p81: figure]
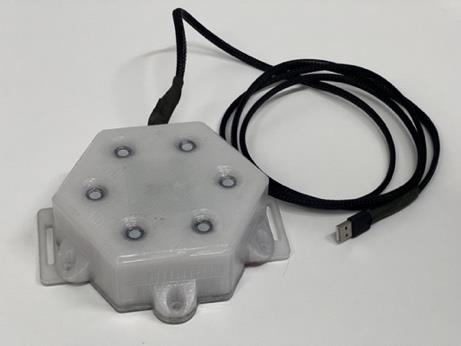
[picture p82: figure]
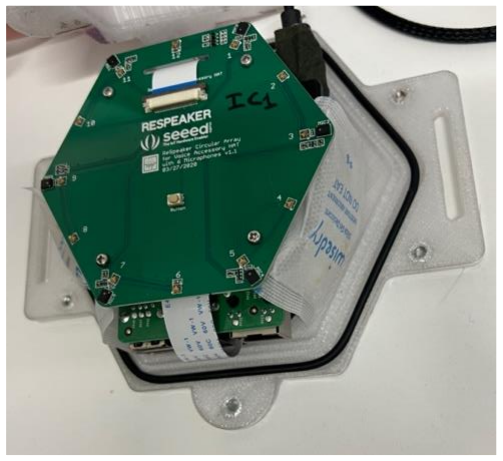
[picture p83: figure]

Connect the USB to USB-C power cable with the Micro-USB to USB-C adapter. Apply duct tape to secure the connection. | Place a new silica gel packet into the position shown (and repeat on the other side of the Pi, for a total of 2 packets). | Place the top casing on top of the device. Make sure to align the screw holes, and tuck in the internal cabling. | One by one, insert the M4 bolts into the holes, and use a screwdriver to screw until tight.

21

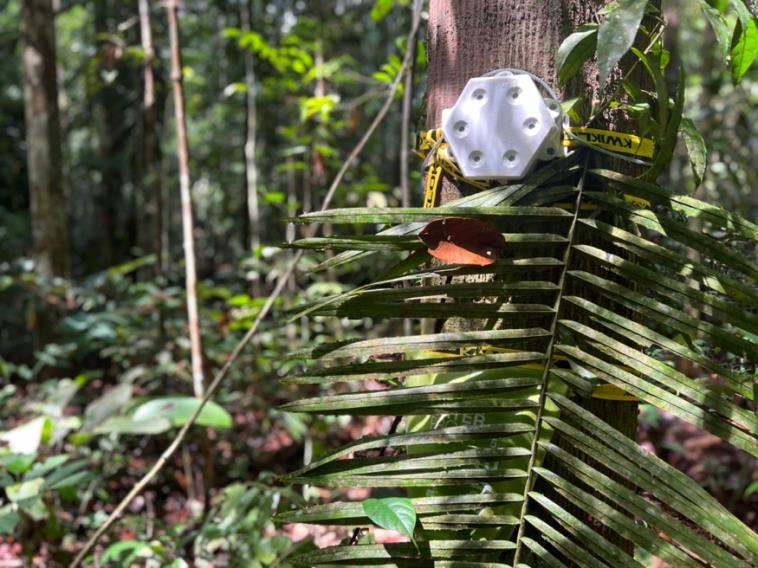
[picture p84: figure]

The device should now be ready for deployment! For deployment instructions, see this document. (https://drive.google.com/file/d/1VqOs3o93QgEigXwGQxT3dmpj0KQSR6Fb/view?usp=share_link) | | | .
