BeckyHeath/MAARU/archive-ugly-website/round2/buildingMAARU.html

MAARU Logo

## Building MAARU

MAARU recorders can be built cheaply and easily using just a power drill and a screwdriver. You’ll need to make sure you have all the kit first, so please see our non-exhaustive kit list.

Please find downloadable setup resources below:

Microphone array and raspbery Pi

### Basic Setup (all deployments)

- Download Instructions
- Project GitHub and setup instructions (https://github.com/BeckyHeath/multi-channel-rpi-eco-monitoring)
- Prebuilt disk image download (https://drive.google.com/file/d/1sTKPgUOcT4SQeJqtF6wdd6rjtqFLZzfR/view)

battery, solar charge controller and a solar panel

### Autonomous Powering

- Download Instructions

battery, solar charge controller and a solar panel

### Basic Case

- Download Instructions

picture of a 3D printed case

### 3D Printed Case

- Download Instructions
- Download CAD files

## Kit List

This section contains the full component list, associated costs (prices rounded up and accurate as of August 2023), and purchase links. Note this has been setup for deployment in the UK and is not exhaustive of compatible elements. Other equipment with the same specification should work just as well.

MAARU can be deployed to suit different levels of required autonomy. Powering and Networking can be altered to suit local resource availibily

### Core Device (for all MAARU deployment types)

Item | Price | Links
Raspberry Pi 4 (4GB) | £55 | here (https://thepihut.com/products/raspberry-pi-4-model-b?variant=20064052740158)
ReSpeaker 6-Mic Circular Array | £37 | here (https://coolcomponents.co.uk/products/respeaker-6-mic-circular-array-kit-for-raspberry-pi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)
High speed micro-SD card 256GB+ | £22 | here (https://www.amazon.co.uk/dp/B09X7CRKRZ/ref=twister_B0BG5YQP69?_encoding=UTF8&th=1)

### Weatherproofing, Teathering and Other

Item | Price | Links
Waterproof container (sandwich box) | £2 | here (https://www.amazon.co.uk/Sistema-Sandwich-ml-Assorted-Colours-Contrasting/dp/B071G1MZK8)
Acoustic Vents (x6) | £3/vent | here (https://www.ipromembrane.com/portable-electronics-vents/waterproof-mobile-phone-mic-vent-ip68-10m-30min/)
Waterproof fabric tape | £18 | here (https://www.amazon.co.uk/Fabric-Webbing-Scapa-Genuine-British/dp/B00HBTYC7A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)
Electical insulation tape | £1 | here (https://www.wickes.co.uk/Deta-Black-PVC-Electrical-Insulation-Tape---20m-x-19mm/p/710074)
Clear silicone sealant | £7 | here (https://www.sainsburys.co.uk/gol-ui/product/ProductDisplay?storeId=10151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)
Silica gel packets | 15p/packet | here (https://www.kitepackaging.co.uk/scp/protection-and-wrapping/silica-gel/?sfpartno=SGEL-10&gad=1)

### Autonomous Powering (optional):

Item | Price | Links
60W 12V Solar Panel | £62 | here (https://www.amazon.co.uk/Renogy-Watts-Volts-Monocrystalline-Camping/dp/B07HR6KDW1)
20A Solar charge controller | £11 | here (https://www.amazon.co.uk/Controller-Topcloud-Parameter-Adjustable-Regulator/dp/B08XX6ZPBP)
12V 24Ah LiFEPO4 Deep cycle battery | £137 | here (https://www.bmstechnologies.co.uk/product/tn-power-lithium-12v-24ah-leisure-battery-lifepo4-tn24/)
12V to 5V Step down converter | £10 | here (https://www.amazon.co.uk/gp/product/B071FT57SV/ref=ppx_yo_dt_b_asin_title_o02_s00?ie=UTF8&psc=1)
Armoured 2-core 13AWG power cable | £3/m | here (https://uk.rs-online.com/web/p/power-cable/1964662?gb=s)
Teathering: slings (x4) | £6/sling | here (https://www.liftinggeardirect.co.uk/lifting-slings/2-tonne-round-sling)
10L Dry Bag | £8 | here (https://www.mountainwarehouse.com/animal-pvc-10l-dry-bag-p41652.aspx/Black/)

### Networking (optional):

Item | Price | Links
4GB USB Dongle | £40 | here (https://www.amazon.co.uk/Huawei-E3372-Cat4-Modem-E3372H-153-White/dp/B013UURTL4?s=electronics)
Unlimited data SIM card | £20/month | here (https://smarty.co.uk/order/unlimited)

© Becky Heath 2023

@Becky_Heath

rh862@cam.ac.uk

MAARU Logo
