BeckyHeath/MAARU/(commit log)

2023-08-25 Add text and schematic to the MAARU about section
2023-10-15 upload the 3D case stuff from James
    [AMARU_BasePlate.STL, AMARU_TopCase.STL]
2023-10-23 okay landing page looking _alright_ - gonna expand to other pages
2023-10-23 Add downloads to build page
    [AMARU_BasePlate.STL, AMARU_TopCase.STL]
2023-10-23 hamburger getting there - text just a bit cut off at the top
2026-07-07 The table broke with the last iteration so switch back
